sinyeol/c6l-contact-lora/README.md

# c6l-contact-lora

M5Stack **Unit C6L** 26대로 만드는 접점 상태판입니다.

- 송신기 25대가 각각 접점 2개를 읽어 LoRa 로 보냅니다.
- 수신기 1대가 받아서 태블릿 웹페이지에 25칸으로 보여 줍니다.
- 펌웨어는 하나뿐이고, 본체 버튼으로 정한 **ID 가 역할을 정합니다**(0 = 수신기, 1~25 = 송신기).

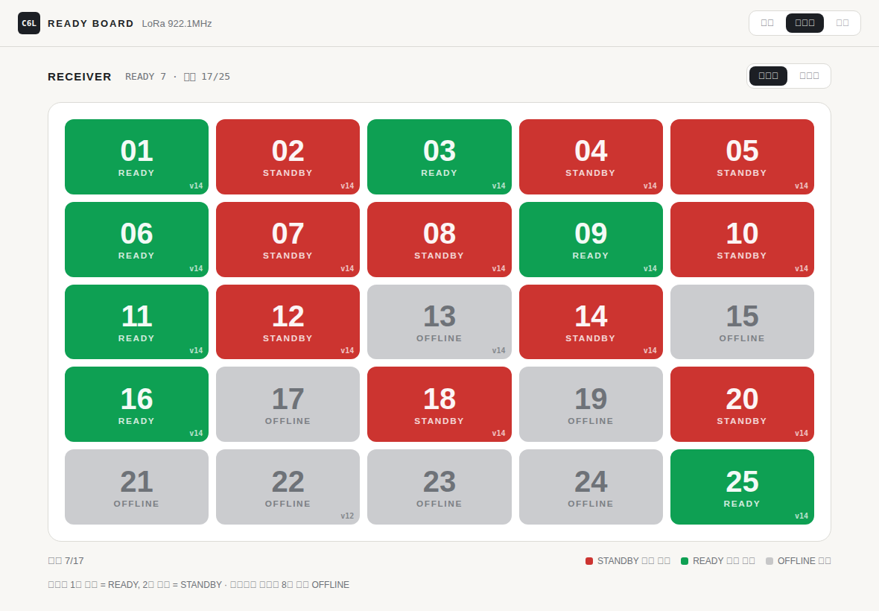
[picture p1: docs/tablet-preview.png]
태블릿 화면 미리보기(가짜 데이터)


## 배선 (송신기)

동봉된 Grove 케이블 한쪽을 잘라 씁니다.

| 선 | 신호 | 연결 |
|---|---|---|
| 흰색 | G4 | 접점 1 |
| 노란색 | G5 | 접점 2 |
| 검은색 | GND | 두 접점의 공통 |
| 빨간색 | 5V | **연결하지 않음** |

- **무전압(dry) 접점만** 연결합니다. 누름버튼(순간 접점)을 기준으로 동작합니다.
- 풀업은 칩 내부 풀업을 씁니다. 외부 풀업이 필요하면 3.3V 에 걸어야 하고, 5V 는 안 됩니다.
- 선이 길면 직렬 1kΩ + GND 쪽 100nF 를 달거나 포토커플러로 분리합니다.

## ID 정하기 (본체 버튼)

1. 버튼을 **2초 길게** 누르면 설정 모드가 됩니다. OLED 에 `SET tap=+1` 이 뜹니다.
2. **짧게** 누를 때마다 ID 가 1 씩 올라갑니다. 25 다음은 `GW`(수신기)입니다.
3. 다시 **2초 길게** 누르면 저장하고 재부팅합니다. 20초 동안 아무것도 안 누르면 저장하지 않고 빠져나옵니다.

공장 상태는 `ID --` 이며, 이때는 아무것도 보내지 않습니다.

**시리얼로 정하기 (USB, 115200):** `id 0`(수신기) 또는 `id 1`~`id 25` 를 보내면 저장하고 재부팅합니다. 그 밖의 줄을 보내면 `id=… radio=… link=… fw=…` 상태를 돌려줍니다.

## 와이파이 일괄 업데이트 (v1.2 부터)

1. 앱 **[업데이트]** → `…-app-0x10000.bin` 을 고릅니다.
2. **[올리고 시작]** 을 누르면 USB 로 수신기에 올라가고, 수신기가 송신기를 한 대씩 와이파이로 업데이트합니다(1대 20초 안팎).
3. 끝나면 **[수신기도 업데이트]** 를 누릅니다.

주의할 점:
- 업로드는 USB 로만 받습니다. v1.1 이하는 USB 로 한 번 구워야 합니다.
- AP 비밀번호는 git 밖 `secrets.h`(`#define C6L_AP_PASS "…"`)로 바꿀 수 있습니다.
- 와이파이 업데이트 뒤 USB 로 앱만 구울 때는 `boot_app0.bin` 을 `0xe000` 에 함께 굽습니다.
- 자세한 내용은 [docs/REPORT.md](docs/REPORT.md) 4.4 절에 있습니다.

**시리얼 로그:**
- 송신기는 누름 ACK 를 받으면 `tx ok …` 를, 8초 동안 수신기 비콘·ACK 가 없으면 `link lost` 를 찍습니다.
- 수신기는 패킷을 받을 때마다 `rx id=… rssi=…` 를 찍습니다.
- LoRa 초기화에 실패하면 `radio init try N: err=… i2c_fail=…` 를 찍고 최대 3번까지 다시 시도합니다.

## OLED 표시

- **송신기:** `ID 07` / `READY`(큰 글씨, 수신기가 READY 로 확인해 준 때만. STANDBY 면 빈칸) / `link OK`. 8초 동안 수신기 비콘·ACK 가 없으면 `link --` 가 됩니다.
- **수신기:** `GW` / `on 21/25` / `192.168.4.1`
- `LoRa ERR` 는 무선 칩 초기화에 실패했다는 뜻입니다. 시리얼 115200 에서 `radio=<코드>` 를 확인합니다.

## 태블릿·PC 화면

각 칸에는 다음이 표시됩니다.
- 상태 **READY**(초록) 또는 **STANDBY**(빨강) 중 하나가 켜집니다.
  - 송신기 전원이 켜지면 STANDBY 입니다.
  - 접점 1 을 누르면 READY 로 바뀌어 그대로 유지됩니다.
  - 접점 2 를 누르면 STANDBY 로 바뀌어 유지됩니다.
  - 송신기 전원이 꺼지면(8초 무소식) 둘 다 OFF 가 됩니다.
- 접점별로 누른 횟수(×N, 255 다음 0, 송신기를 재부팅하면 0)
- 마지막 수신 경과 시간과 RSSI

화면을 보는 방법은 두 가지이고, 같은 페이지(`page.h`)를 씁니다.

**1) USB 앱 (수신기를 USB 로 연결)**
- 주소: **https://sinyeol.github.io/c6l-contact-lora/web/** (GitHub Pages). PC 라면 `web/index.html` 을 로컬 파일로 열어도 됩니다.
- 처음에 [USB 연결]을 눌러 수신기 포트를 고르면, 다음부터는 저절로 연결됩니다.
- **와이파이·인터넷 없이 쓰기:** 인터넷이 될 때 그 기기에서 주소를 **한 번** 열고(태블릿은 '홈 화면에 추가'), 그 뒤로는 오프라인에서 열립니다.
  - 서비스워커(`web/sw.js`)가 페이지·아이콘·폴리필을 저장해 둡니다.
  - 수신기와는 USB 로만 통신합니다.
  - 저장본을 먼저 보여 주고, 인터넷이 있으면 새 버전을 받아 둡니다(다음에 열 때 반영).
- 수신기는 USB 로 1초마다, 그리고 패킷을 받을 때마다 `S [...]` 상태 줄을 보냅니다.
- 지원 브라우저: PC 크롬·엣지, 안드로이드 크롬(Web Serial 은 148+·Android 17, 그보다 낮으면 WebUSB 폴리필). **iPad/Safari 는 안 됩니다.**
- `page.h` 를 고친 뒤에는 `python3 tools/export_web.py` 로 `web/index.html` 을 다시 만듭니다.

**2) Wi-Fi (수신기 AP)**
1. 휴대폰이나 태블릿을 **`C6L-GW` / 비밀번호 `c6l-12345`** 에 연결합니다.
2. 브라우저에서 **http://192.168.4.1** 을 엽니다(0.3초마다 갱신).

8초(하트비트 2번 반) 동안 소식이 없으면 칸이 흐려지고 `끊김` 으로 바뀌며, READY·STANDBY 가 모두 OFF 가 됩니다. SSID·비밀번호는 `c6l-contact-lora.ino` 맨 위에서 바꿉니다.

## 동작 방식

- **무선 설정:** 922.1MHz(KR920 채널), SF7, BW125k, CR4/5, +10dBm(동봉 3dBi 안테나로 EIRP 13dBm). 패킷 하나에 약 36ms, ACK 에 약 31ms 가 걸립니다.
- **송신:** 누르면 ACK 를 받는 패킷을 바로 보내고, 평소에는 3초(+지터)마다 ACK 없는 하트비트를 보냅니다. 수신기는 3초마다 비콘으로 각 송신기의 상태를 되돌려 줍니다. 25대 기준으로 채널의 약 33% 를 씁니다. 보내기 전에 5ms 이상 들어 -65dBm 이하일 때만 보내고, 보낸 뒤 50ms 이상 쉽니다(국내 LBT, 수신기 ACK 도 같음). 수신기가 300ms 안에 ACK 를 주지 않으면 다시 보냅니다.
  - 누름 재전송은 50~250ms×시도 횟수로 7번이고, 그래도 안 되면 다음 하트비트가 상태를 실어 보냅니다.
  - 패킷에 현재 상태 전체를 담기 때문에 중간 패킷을 잃어도 다음 패킷이 바로잡습니다.
- **짧은 클릭:** 전송 사이에 열렸다 닫혀도 카운터가 올라가므로 화면의 ×N 으로 확인할 수 있습니다.
- **패킷 형식:** `C6 01 id seq bits cnt1 cnt2`, ACK 는 `C6 02 id seq bits` 입니다.
  - ACK 의 `bits` 는 수신기가 저장한 상태입니다. 송신기는 이 값을 화면에 띄우므로, 송신기 화면이 곧 수신기에 들어간 상태입니다.
  - 비콘 `C6 04` + 7바이트(25대 × 2비트)를 받으면 송신기는 자기 칸으로 READY 를 맞추고, 8초 동안 못 받으면 READY 를 지웁니다.

## 빌드·플래시

```bash
arduino-cli core install esp32:esp32        # 3.3.x, 보드 URL: https://espressif.github.io/arduino-esp32/package_esp32_index.json
arduino-cli lib install RadioLib U8g2       # RadioLib 8.x 기준 (7.x 와 begin() 형식이 다름)
arduino-cli compile --fqbn esp32:esp32:esp32c6:CDCOnBoot=cdc,PartitionScheme=no_fs --export-binaries .
arduino-cli upload  --fqbn esp32:esp32:esp32c6:CDCOnBoot=cdc,PartitionScheme=no_fs -p /dev/ttyACM0 .
```

- **USB 가 다른 PC 에 꽂혀 있을 때(Claude 세션):** Claude in Chrome 으로 그 PC 크롬에 esptool-js 를 엽니다.
  - 처음 한 번은 Connect 를 누르고 사용자가 포트를 고릅니다. 그다음 `file_upload` 로 바이너리를 넣고 0x0 에 굽습니다.
  - 권한을 받은 포트는 페이지에서 `import('https://cdn.jsdelivr.net/npm/esptool-js@0.7.1/+esm')` 로 불러온 `ESPLoader` 로 포트 선택 없이 다시 구울 수 있습니다.
  - 합본 이미지는 NVS 까지 덮어쓰므로 굽고 나면 `id N` 을 다시 보냅니다.
  - 리셋은 `setSignals({DTR:false, RTS:true})` 를 했다가 둘 다 false 로 돌립니다. DTR 이 켜진 채 리셋하면 다운로드 모드로 들어갑니다.
- **arduino-cli 없이 굽기:** `build/esp32.esp32.esp32c6/c6l-contact-lora.ino.merged.bin` 을 [esptool-js](https://espressif.github.io/esptool-js/) 로 주소 `0x0` 에 굽습니다.
- **다운로드 모드:** 측면 버튼을 녹색 LED 가 빨강으로 바뀔 때까지 누르고 있다가 뗍니다.

## 케이스 (3D 프린트)

Unit C6L + 배터리 + 3버튼 모듈(ST003)을 담는 케이스 설계툴: **https://sinyeol.github.io/c6l-contact-lora/case/**
치수·배치를 슬라이더와 드래그로 바꾸고 STL(뚜껑·통·자석 바닥)을 바로 받습니다. 구조·부품표·Fusion 사용법은 [case/README.md](case/README.md).

## 출처·주의

- **핀·IO 확장칩 초기화:** Meshtastic `variants/esp32c6/m5stack_unitc6l` 기준입니다.
- **RF 설정(TCXO 3.0V on DIO3, RF 스위치 = DIO2):** Stamp C6LoRa 회로도에서 가져왔습니다.
- **안테나:** 동봉 LoRa 안테나는 868MHz 용입니다. 국내(920MHz 대)에서는 915~923MHz 안테나가 낫습니다.
- **국내 920MHz 규정 고정:** 펌웨어 맨 위 `static_assert` 가 범위 밖 설정이면 빌드를 막습니다. 실행 중에 주파수를 바꾸는 명령은 없습니다.
  - 채널: 920.9~923.3MHz, 200kHz 간격
  - EIRP: 920.9~921.9MHz 10dBm, 922.1~923.3MHz 14dBm (`TX_DBM + ANT_GAIN_DBI`)
  - 868.1·922.0MHz, 14dBm, 921.1MHz@13dBm 은 빌드가 막히는 것을 확인했습니다.
  - 안테나를 바꾸면 `ANT_GAIN_DBI` 를 고칩니다.
  - 수치 출처는 LoRaWAN KR920·TTN·국내 논문 등 2차 자료입니다. 현행 무선설비규칙 원문 대조와 기기 자체의 KC 적합성평가 여부는 별도로 확인해야 합니다.
- **2대 연동 실기기 확인(2026-11-09):**
  - 송신기 1번 `tx ok`/`link=ok`, 수신기 `rx id=1`(ACK 포함)
  - 접점 입력이 `bits=1 c=1/2` 로 수신기까지 전달
  - 사무실 PC 크롬에서 USB 앱으로 01번 READY ON 표시
  - GitHub Pages 주소(https://sinyeol.github.io/c6l-contact-lora/web/)에서 포트 권한을 받은 뒤 자동 연결, 래치(1→2→1 누름 → READY 유지)가 앱에 초록 READY 로 표시, 송신기 ACK `synced=` 로 동기화 확인
- **수신기 실기기 확인(2026-11-09, 2번째 모듈):**
  - 시리얼 `id 0` 으로 GW 로 설정하자 OLED 에 `GW` 가 표시됐습니다.
  - 첫 부팅에서 `radio=-2` 가 한 번 났지만, 이후 리셋 6번은 모두 `radio=0` 이었습니다. 그래서 초기화 재시도를 넣었습니다.
- **송신기 실기기 확인(2026-11-09, 1대):** 다음 항목이 실제 기기에서 정상이었습니다.
  - esptool-js 로 굽기
  - 부팅 로그 `radio=0`(IO 확장칩·SX1262·TCXO 3.0V·DIO2 RF 스위치 정상)
  - OLED(`U8G2_SSD1306_64X48_ER`) 표시
  - 버튼(P0)으로 ID 설정 → NVS 저장 → 재부팅 후 `id=1`
- **미검증:** 수신기 Wi-Fi AP·192.168.4.1 페이지, 안드로이드 태블릿(Web Serial·WebUSB), 25대가 동시에 바뀔 때의 전달 시간.
