sinyeol/c6l-contact-lora/(commit log)

2026-11-09 Unit C6L 접점 2개 LoRa 송신기 25대 + 수신기 태블릿 상태판 펌웨어
    - 한 펌웨어, 본체 버튼으로 ID 설정(0=수신기, 1~25=송신기, NVS 저장)
    - 송신기: G4/G5 접점 디바운스·닫힘 카운트, 변화 시/30초마다 CAD 후 송신, ACK 재전송
    - 수신기: ACK 응답, Wi-Fi AP(C6L-GW) + http://192.168.4.1 25칸 상태 페이지
    - 핀·IO 확장칩 초기화는 Meshtastic m5stack_unitc6l, TCXO 3.0V·DIO2 RF 스위치는 회로도 기준
    - RadioLib 8.0 / arduino-esp32 3.3.12 컴파일 확인, 실기기 미검증
2026-11-09 README: 실기기 1대 확인 결과 반영 (굽기·radio=0·OLED·버튼 ID 저장)
2026-11-09 시리얼 id 명령·상태 응답·송수신 로그, LoRa 초기화 3회 재시도
    - 시리얼 "id N"(0~25)으로 ID 저장 후 재부팅, 그 밖의 줄은 id/radio/link 상태 응답
    - 송신기 tx ok / link lost, 수신기 rx id=.. rssi=.. 로그
    - 새 모듈 첫 부팅에서 radio=-2 가 한 번 나 확장칩·SX1262 리셋부터 3회 재시도, I2C 쓰기 실패 수 기록
    - 수신기 모듈 실기기: id 0 → GW, 리셋 6회 모두 radio=0
2026-11-09 USB 앱(Web Serial) 추가, 접점 표시를 READY(초록)·STANDBY(빨강)로
    - 수신기가 USB 로 1초마다·수신 즉시 "S [...]" 상태 줄 출력 (웹 /s 와 같은 JSON)
    - page.h 하나로 Wi-Fi(http) 폴링과 USB(Web Serial, 안드로이드 구버전은 WebUSB 폴리필) 모드 겸용
    - 포트 연 뒤 DTR/RTS 를 내려 리셋 시 다운로드 모드로 멈추는 것 방지
    - tools/export_web.py: page.h → web/index.html 사본 추출
    - 실기기: 송신 1번 ↔ 수신기 링크·접점 입력 전달, 사무실 PC 크롬에서 USB 앱 표시 확인
2026-11-09 송신기 READY/STANDBY 래치, 하트비트 10초·끊김 35초, 꺼지면 둘 다 OFF
    - 전원 켜면 STANDBY, 접점1 누르면 READY 유지, 접점2 누르면 STANDBY 유지 (누를 때만 전송)
    - 비트: 1=READY, 2=STANDBY — 수신기·앱은 그대로 표시, 송신기 OLED 둘째 줄도 상태 표시
    - 하트비트 30→10초, 끊김 75→35초(하트비트 3번): 전원이 꺼지면 앱에서 35초 안에 둘 다 OFF
2026-11-09 ACK 에 수신기 저장 상태를 되돌려 송신기 OLED 가 동기화된 READY 만 표시
    - ACK = C6 02 id seq bits — 수신기가 저장한 상태를 돌려줌, 송신기는 syncedBits 로 보관
    - 송신기 OLED: ID 아래 큰 글씨 READY (수신기 확인 때만), STANDBY 는 빈칸, 접점 1·2 상태 표시 제거
    - ACK 8회 연속 실패 시 syncedBits 초기화(READY 지움), 로그에 synced= 추가
2026-11-09 OLED 180도 회전 (U8G2_R2) — 사용자 확인: R0 은 뒤집혀 보임
2026-11-09 README: Pages 앱 실기기 시험 결과(자동 연결·래치·동기화)
2026-11-09 국내 920MHz 규정 고정(대역·채널·EIRP 빌드 검사, RSSI LBT·50ms 쉼), 앱 오프라인(PWA)
    - static_assert: KR920 채널(920.9~923.3MHz, 200kHz)·EIRP(920.9~921.9 10dBm / 922.1~923.3 14dBm) 밖이면 빌드 실패
    (868.1·922.0MHz, 14dBm, 921.1MHz@13dBm 모두 막히는 것 확인)
    - LBT: CAD 대신 5ms 이상 순간 RSSI ≤ -65dBm 일 때만 송신, 송신 뒤 50ms 쉼 — 송신기·수신기 ACK 공통(krTransmit)
    - 앱: manifest·서비스워커(sw.js)·아이콘, web-serial-polyfill(Apache-2.0) 로컬 사본 — 한 번 연 뒤 인터넷 없이 동작
2026-11-09 README: 국내 920MHz 규정 고정·LBT, 앱 오프라인 사용법
2026-11-09 docs: v1.0 완료 보고서 (구성·동작·배선·설치·국내 규정·통신 규격·검증·남은 일)
2026-11-09 docs: 보고서에 트러블슈팅(증상→원인→해결) 추가
2026-11-09 꺼짐 판정 35초 → 8초: ACK 없는 3초 하트비트 + 수신기 비콘 동기화
    - 하트비트 T_HB(ACK 없음) 3초+지터, 누름 T_STATE 만 ACK — 25대 채널 약 32%
    - 수신기 비콘 T_BEACON 3초마다: 살아 있는 송신기 상태 2비트×25(proto.h) — 송신기는 자기 칸으로 READY 동기화·링크 판단
    - 꺼짐 판정 8초(수신기·앱), 송신기 link lost 8초(비콘·ACK 없음), 송신기도 평소 수신 모드
    - 누름 ACK 7회 실패 시 하트비트가 상태 전달, 수신기 로그는 누름·변화만
    - proto.h 비트 묶기 호스트 시험(tools/test_proto.cpp), 앱 OFF=8, 서비스워커 캐시 v2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
2026-11-09 docs: 8초 꺼짐 판정(하트비트·비콘) 반영, 배터리 사용 시간 계산 추가
2026-11-09 송신기: 누름 재시도 중에는 하트비트를 끼워 넣지 않음
2026-11-09 앱: USB 연결 시 RTS→DTR 순서로 신호를 내려 수신기 재부팅 방지
    - 실기기 시험: RTS→DTR 은 리셋 없음, 동시·DTR→RTS 는 'DTR 꺼짐·RTS 켜짐' 순간이 생겨 C6 리셋
    - 기존 앱은 연결할 때마다 수신기를 재부팅시켰음(상태표 초기화)
    - 서비스워커 캐시 v3, 보고서 트러블슈팅에 추가
2026-11-09 docs: 꺼짐 판정 8초 실측(마지막 수신 뒤 8.0초)·비콘 동기화·USB 신호 순서 검증 기록
2026-11-09 docs: v1.1 (꺼짐 8초·USB 재부팅 수정) 버전·변경 이력
2026-11-09 와이파이 일괄 업데이트: 앱 → USB → 수신기 보관 → 송신기 한 대씩 OTA (v1.2)
    - 하트비트·누름에 펌웨어 버전(8번째 바이트), 수신기는 7바이트(v1.1 이하)도 받음, 앱 칸에 v 표시
    - 수신기: 시리얼 "fw <크기> <버전>" + 1KB 조각/ack 로 다음 OTA 영역에 보관(esp_ota_*, 부팅 대상 유지),
    GET /fw.bin 으로 제공, "upd all|ids" 로 한 대씩 T_OTA 명령(5초 재시도, 150초 제한, 새 버전 하트비트면 완료),
    "fw apply" 로 수신기 자신 적용
    - 송신기: T_OTA(목표 버전이 다를 때) → 수신기 AP 접속 → httpUpdate → 재부팅, 실패 시 LoRa 복귀, OLED 진행률
    - 앱: [업데이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
2026-11-09 v1.4: 일괄 업데이트 중에는 재업로드 막음 (수신기 fw err busy, 앱 버튼은 U done 까지 잠금)
    - 실기기 시험(v12→v13 와이파이 업데이트)에서 업로드가 두 번 돌았음 — 송신기가 받아 가는 보관본을
    업데이트 도중 덮어쓸 수 있는 틈이었다
    - 실기기 결과: 앱 → USB → 수신기 보관 → 송신기 25 와이파이 OTA → v13 확인, 수신기 fw apply → v13
    - FW_VERSION 14, 서비스워커 캐시 v5
2026-11-09 docs: v1.4 와이파이 일괄 업데이트(사용법·명령·검증·트러블슈팅·USB 재굽기 주의)
2026-11-09 Ready Board 디자인 (레퍼런스: gametools.crowny.org 딜러 화면 토큰), v1.5
    - 레퍼런스 공통 토큰(OKLCH bg/fg/panel/line/muted/red/green/disabled, Helvetica Neue, 카드 18px·칸 12px) 그대로 —
    로고·이름은 쓰지 않음
    - 5×5 고정 그리드가 화면 높이를 채움, 칸: 큰 번호 + READY/STANDBY/OFFLINE 라벨 + 펌웨어 버전
    STANDBY(빨강)=전원 연결·대기, READY(초록)=버튼 누름, OFFLINE(회색)=꺼짐
    - 그리드/카운트 보기(READY/연결 + 진행 막대 + 대기 번호 + ALL READY), 자동/라이트/다크 테마(기기에 기억)
    - 상단 RECEIVER 줄에 READY·연결 수·수신기 버전, 범례, 업데이트 대화상자도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
2026-11-09 docs: v1.5 패키지 이름·변경 이력
2026-11-09 case: C6L 버튼 케이스 설계툴 (브라우저 3D·STL + Fusion 스크립트)
    Unit C6L + 카드형 배터리 + 3버튼 PCB 를 담는 3D 프린트 케이스.
    - core.js: 파라미터 → 배치 → 경고 → CSG 트리(단일 진실), case.json
    - csg.js: manifold-3d 3.5.4 로 메시·STL, app.js: 플라이트 케이스 앱 틀(슬라이더·3D·평면·단면·경고)
    - C6LCaseBuild: case.json 트리를 Fusion TemporaryBRepManager 로 해석
    - check.mjs: 기본값 오류 0, Base·Lid 부피, 슬라이더 양 끝 계산
    배터리 88×56×9·스위치 12×12×7.3 은 가정값, Fusion 실행은 미검증.
2026-11-09 case: 3부품 구조(뚜껑·통+격판·자석 바닥), 드래그 배치, OLED 마스크·인서트
    - 배터리 99×65×12, 아래 칸에 넣고 자석 4쌍 바닥으로 여닫음(손가락 홈)
    - 가운데 격판 + 패널형 USB-C(JRC-C009) 자리(M2 인서트), 배터리 밖 케이블 자리
    - 뚜껑 3mm, OLED 둘레 1mm + 45° 경사 마스크(frustum 노드), C6L 버튼 Ø3, 버튼 2개
    - 볼트 자리는 열삽입 인서트(M3 L5.7 모서리 기둥, M3 L4 PCB 기둥), 필요 부품표
    - 안테나 벽 1mm(바깥 Ø10 파기)
    - 평면도에서 C6L(Y)·PCB·USB-C 드래그, Fusion 은 사각뿔대를 테이퍼 압출로
2026-11-09 case: 버튼 PCB 회전, 전원 경로 선택(USB-C 커넥터·케이블 구멍·없음)
    - PCB_ROT 0/90/180/270 (중심 기준 회전, 헤더 위치 표시), EXTRA_Y 로 안쪽 깊이 추가
    - USB_MODE: 격판 패널 커넥터 / 격판 케이블 구멍(배터리 케이블을 C6L USB-C 에 직결,
    C6L +Y 쪽 플러그 자리 검사) / 없음
    - DEFS 9번째 항목 = 선택지 → 사이드바 셀렉트(회전·가운데 버튼·방향·전원 경로)
    - ST003 모듈 사진 확인: 헤더 핀·LED 가 위로, 둥근 캡 → 안내 문구
    - check.mjs 가 선택지 값마다 세 부품을 계산
2026-11-09 case: Fusion 스크립트가 다운로드의 c6l-case*.json 중 최신을 읽음, 맥 설치 명령
2026-11-09 case: 케이블 구멍 길이 최대 80·폭 최대 50mm
2026-11-09 case: 그립용 둥근 테두리(윗면·아랫면 R), 마스크 두께 = 뚜껑 두께 NaN 수정
    - 바깥 외피 하나(세로 R 7 + 윗면 R 3.5 + 아랫면 R 3.5)를 높이로 잘라 뚜껑·통·바닥에 나눔
    - torus 노드(manifold: 1/4 revolve, Fusion: TemporaryBRepManager.createTorus)
    - 검사: 테두리 R 로 얇아지는 벽 두께, 뚜껑 볼트 머리 자리가 곡면에 걸리는지
    - 기둥 채움을 둥근 안쪽 공간으로 잘라 세로 R 이 커도 밖으로 안 튀어나옴
    - MASK_T = LID_T 일 때 경사면 크기 0/0 → NaN 으로 WASM 이 죽던 문제(경사면 생략)
2026-11-09 case: C6L 고정 — 격판 누름 받침, 안테나 벽 밀착, 레고 핀 Ø4.9
    - 격판 위 받침 4개(Ø6, 뒷면 나사·레고 구멍 피함)가 뚜껑을 닫으면 C6L 을 0.3mm 눌러 고정(C6L_PRESS)
    USB-C 자리와 겹치는 받침은 빼고 경고
    - C6L SMA 끝을 -X 벽 안쪽면에 붙임(여유 0) → 안테나 조이면 벽을 사이에 두고 당겨짐, SMA 노출 5mm
    - 레고 핀 기본 Ø4.9(최대 5.2), 평면·단면에 받침 표시
2026-11-09 docs: 케이스 설계툴 GitHub Pages 주소
2026-11-09 case: 부품 위치 X·Y 따로 가운데 정렬 버튼(C6L 은 Y 만)
2026-11-09 case: Fusion 스크립트가 모르는 형상을 만나면 다시 받으라고 알림
    맥에 받아 둔 옛 스크립트(torus 이전)가 새 case.json 의 torus 노드를
    자식 목록으로 읽다가 'float' object is not subscriptable 로 죽은 사례.
2026-11-09 case: Fusion 둥근 외피를 필렛 기능으로(토러스 퇴화로 합치기 깨짐), 완료 창에 부피
    - 바깥 외피를 rslab 노드 하나로: 브라우저는 기존 원기둥+1/4 토러스 전개(expandRslab),
    Fusion 은 세로 R 둥근 상자를 만든 뒤 윗면·아랫면 둘레에 filletFeatures 를 건다
    - 기본값(세로 R 7, 테두리 3.5)에서 Fusion createTorus 가 큰 반지름 = 작은 반지름(horn)이라
    합치기가 깨져 모서리 혹·테두리 막대·단차가 생긴 문제(사용자 Fusion 화면)
    - 테두리 R 한도 R/2 → R − 0.5
    - Fusion 완료 창에 부품별 치수·부피 표시
2026-11-10 case: 이음선을 낮춰 배터리를 통이 잡게(SEAM_H 기본 4, +X 멈춤턱, 손가락 홈을 높은 쪽 부품에)
    기둥이 벽 곡면에 딱 맞닿아 떨어지던 부피 0 조각을 없앰(0.05 겹침), check.mjs 에 조각 검사.
2026-11-10 case: 통 배터리 칸 앞·뒤 벽에 누름 리브 4개(RIB_PRESS 0.3, 아래 2mm 조임 0 으로 시작)
2026-11-10 case: 뚜껑·바닥을 통 구멍에 끼우는 판으로(옆면 이음선 없음), LoRa·Wi-Fi 안테나 참고 부품
    - 통이 바닥~윗면 옆벽 전부, 뚜껑·바닥은 같은 외피로 자른 끼움 판(FIT 0.2). 뚜껑은 기둥 위에 얹혀 볼트, SMA 홈 윗부분은 뚜껑 혀가 메움.
    - 바닥: 판 + 모서리 자석 기둥(SEAM_H), 통 앞벽 아래 반달 홈으로 판 모서리에 손톱. 멈춤턱·누름 리브는 통에 0~격판.
    - PCB 기둥을 끼움 판 윤곽으로 잘라 통 벽과 겹치지 않게(겹침 6.6mm³ → 0).
    - REF_antLoRa(108, −Y)·REF_antWiFi(84, +Y), 꺾음 90/45/0°.
2026-11-10 case: 뚜껑·바닥 결합 방식 선택(JOINT: 끼움 = 옆면 이음선 없음 / 얹기 = 높이로 나눔)
    얹기는 e6558a3 이전 형상 그대로(뚜껑 전체 외피, 바닥 트레이, 이음선 손가락 홈), 단면도도 방식별로.
2026-11-10 case: 결합 방식 이름을 끼움형·적층형으로
2026-11-10 case: 끼움형 손가락 홈은 바닥판 혀로 메워 안이 안 보이게, 끼움 판 귀퉁이 R·둘레 테두리 R
    - 홈: 바닥판 높이는 벽을 다 파고 바닥판 혀가 바깥면까지, 그 위 1.5mm 는 벽 바깥만(안쪽 0.8 막).
    - PLATE_R(판 귀퉁이 = 통 구멍 귀퉁이, 귀퉁이 벽 1.2 미만 경고), EDGE_R(판 바깥면 둘레, 판 두께·귀퉁이 R − 0.5 까지).
    - expandRslab 을 자기 상자로 잘라 테두리 R 이 판 두께 절반보다 커도 반대 면 밖으로 안 나가게.
2026-11-10 case: 끼움형 바닥 손가락 홈 혀(옆으로 튀어나와 부러짐) 없애고 바닥판에 손가락 구멍
2026-11-10 case: USB-C 를 격판 위 받침벽에 90° 로 세우고 배터리 케이블이 격판 구멍으로 올라와 꽂는 방식(기본)
2026-11-10 case: 세운 USB-C 플러그 표시 없애고 케이블 구멍·받침벽 위치를 따로, 받침벽 5mm + 뒷면 양끝 리브
2026-11-10 case: 사이드바 검색 칸·묶음 접기(바꾼 개수)·지금 방식에서 안 쓰는 항목 숨기기
2026-11-10 case: 사이드바 묶음 제목 강조, 마지막 case.json 저장 이후 수정한 값은 색으로 표시
2026-11-10 case: 세운 USB-C 받침벽을 격판 위에서 뚜껑 밑으로 옮김(커넥터는 격판·뚜껑 사이 가운데)
2026-11-10 case: 분해 화면에서 참고 부품이 잡는 부품을 따라 움직이게(USB-C 세움·안테나 = 뚜껑, 리브 있으면 배터리 = 통)
2026-11-10 case: 바닥 손가락 구멍을 반달 모양으로, 위치(드래그)·크기·둥근 쪽 방향 조절
2026-11-10 case: 바닥 고정 방식 선택 — 자석(기본) / 볼트(바닥에서 통 기둥 관통, 뚜껑 밑 기둥 인서트에 체결)
2026-11-10 case: 끼움형은 통 안쪽·모든 모서리 기둥 바깥 귀퉁이도 끼움 판 귀퉁이 R 을 따름(기둥 자리를 깎으면 오류)
2026-11-10 case: 출력 버튼 캡(Keys) 추가 — 스템에 끼우고 뚜껑 밑 홈의 턱으로 걸림
2026-11-10 case: 격판을 별도 판(Shelf)으로 분리, 통 기둥·멈춤턱 밑 45° 원뿔 — 서포트 없는 출력
    통 기둥은 격판 높이에서 1.2mm 가늘어진 턱으로 격판을 받치고, 바닥 기둥은 원뿔 자리를 판 깔때기로
    맞닿는다(자석 자리는 원뿔 면에 수직). SEAM_H 기본 7.5.
2026-11-11 case: 볼트 바닥 — 격판 귀퉁이 기둥을 바닥 볼트가 함께 조이고 손가락 구멍 없앰
2026-11-11 case: C6L 레고 핀에 탭 구멍(M3 셀프탭) — 밑에서 볼트 고정, 격판에 머리 자리
2026-11-11 case: 끼움형 바닥판 평면 받침 — 통 기둥이 벽 따라 1.2mm 띠로 z=0 까지, 원뿔 면은 띄움
2026-11-11 case: 배터리 +X 멈춤턱 제거 — 리브 조임과 모서리 기둥으로 잡음
2026-11-13 case: 끼움형 바닥·통 기둥 45° 원뿔 제거 — 평평한 면으로 마주봄(통 기둥 밑면 서포트)
2026-11-13 case: 바닥·통 기둥 45° 원뿔 되돌림 — 평면 이음은 통 기둥 밑에 서포트가 필요해서
    Revert f511caa. 평면 받침 띠는 그대로 둔다.
